adib00227800/ultrasonic-ceiling-localization/images/IMG_7333 (1).jpeg

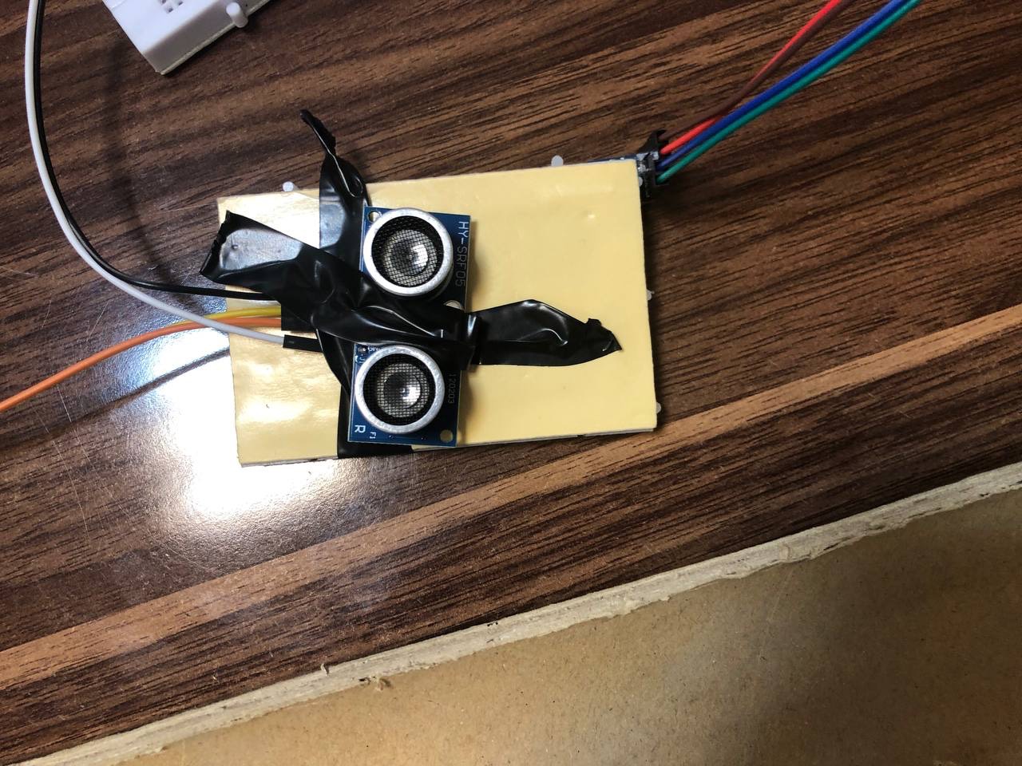
images/IMG_7333 (1).jpeg
