adib00227800/ultrasonic-ceiling-localization/images/IMG_7334.jpeg

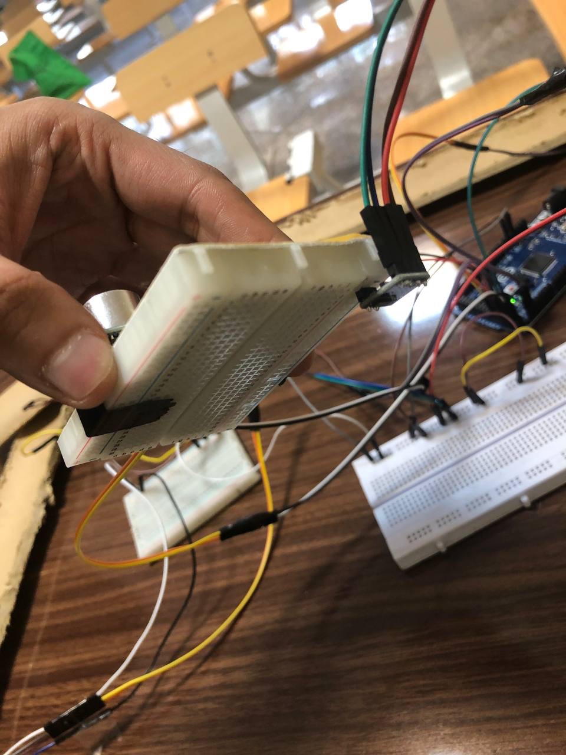
images/IMG_7334.jpeg
